petmar0/SPLOTV2/Spectrum Shield.png

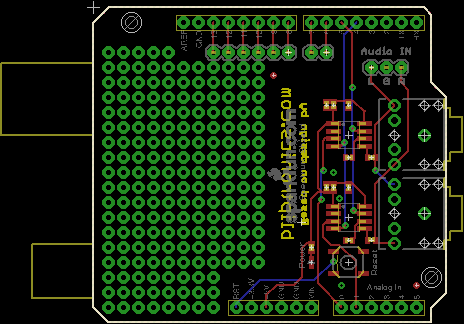
Spectrum Shield.png
