petmar0/SPLOTV2/splotutorial-00.jpg

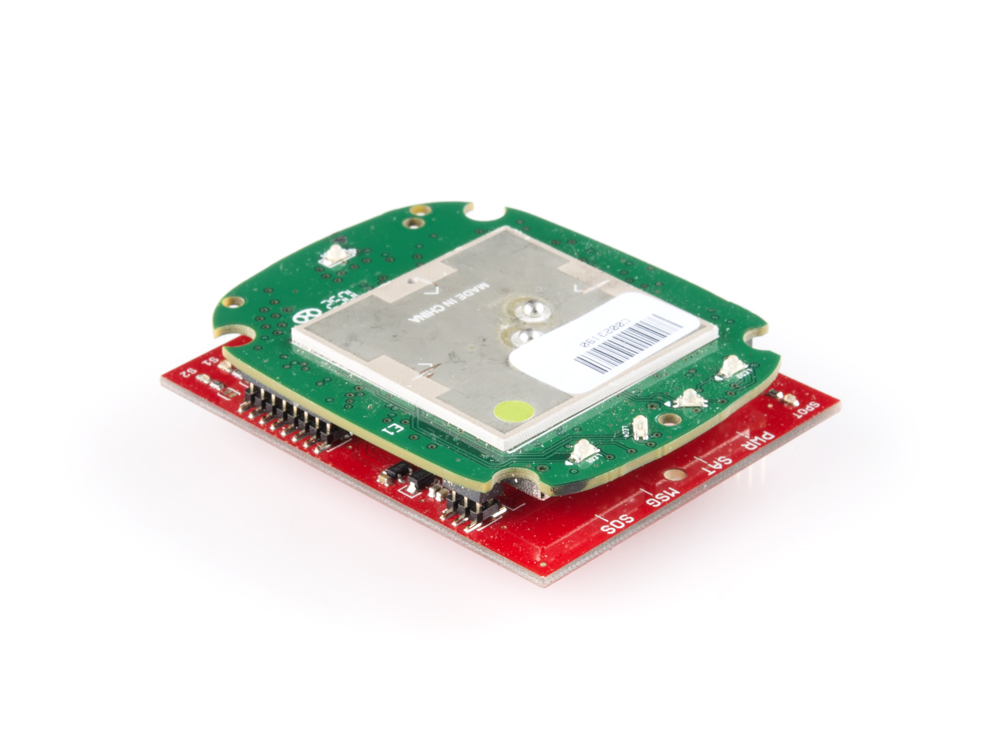
splotutorial-00.jpg
