petmar0/SPLOTV2/splotutorial-01.jpg

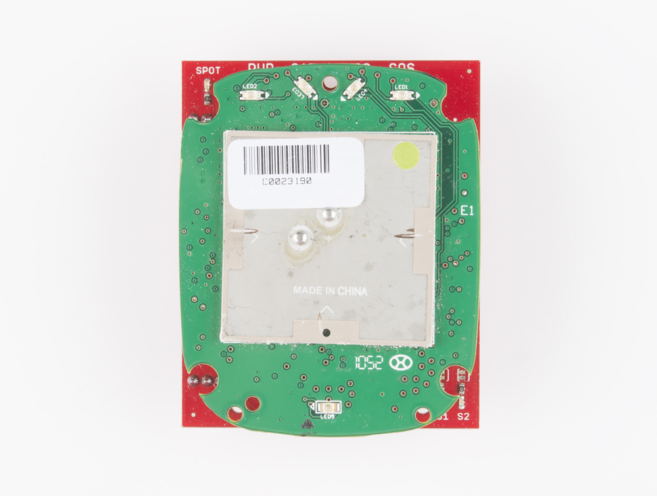
splotutorial-01.jpg
