petmar0/SPLOTV2/splotutorial-03.jpg

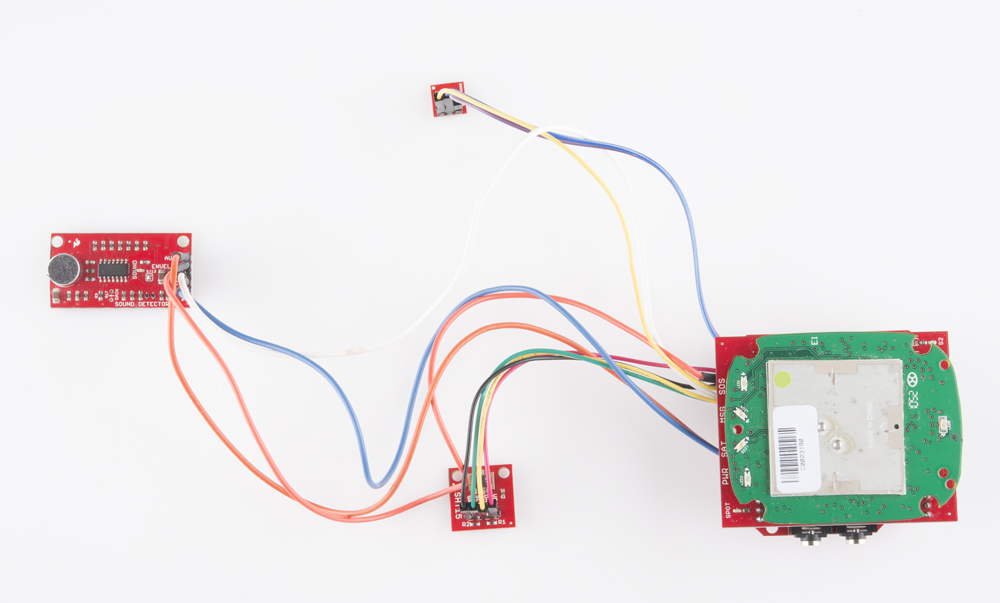
splotutorial-03.jpg
