petmar0/SPLOTV2/splotutorial-04.jpg

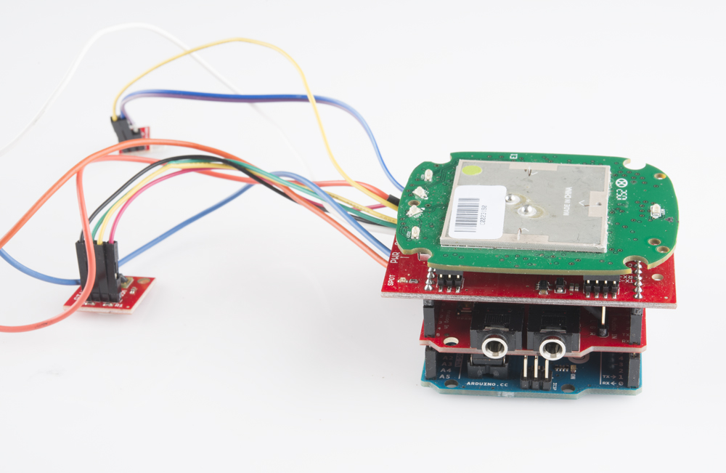
splotutorial-04.jpg
